gazaki/Retro-Le-Go-Boy/README.md

# Retro-Le-Go-Boy
A ESP32 S3 Retro-go PCB design for the LEGO Gameboy Model
