gazaki/Retro-Le-Go-Boy/V2/KiCad/bom/Retro-Le-Go-Boy v2 DigiKey.xlsx

Country of Origin may be different at time of shipment.
The HTSUS and ECCN information shown is for informational purposes only and is not a representation or warranty as to the accuracy or reliability of these classifications. All information is provided "as is" and is subject to change without notice. Any use made of the information provided is without recourse to Digi-Key and at the user's risk.
Index | Manufacturer Part Number | Manufacturer Name | Description | Lead Time | Availability | Stock Status | Attrition % | Requested Quantity 1 | Pack Quantity 1 | Pack Type 1 | Digi-Key Part Number 1 | Unit Price 1 | Extended Price 1 | Minimum Order Quantity 1 | Customer Reference | Requested Part Number | Lead Weeks | Datasheet | Reference Designator | US Import Tariff | Note | Part Status | RoHS Status | Moisture Sensitivity Level (MSL) | ECCN | HTSUS | Country of Origin | Environmental Information | Original Part numbers | Image | Product Notes
1 | CL10B105KP8NNNC | Samsung Electro-Mechanics | CAP CER 1UF 10V X7R 0603 |  | 3,430,644 | In Stock |  | 6 | 6 | Cut Tape (CT) | 1276-1946-1-ND | 0.08000 | $0.48 | 1 |  | 1276-1946-2-ND | 31 | https://mm.digikey.com/Volume0/opasdata/d220001/medias/docus/3584/CL10B105KP8NNNC_Spec.pdf |  | May apply on shipments to the U.S. |  | Active | ROHS3 Compliant | 1 (Unlimited) | EAR99 | 8532.24.0020 | China | https://www.samsungsem.com/files/fileDown.do?key=ed1dfdfa-645e-4252-b707-17f9b1502dd1|https://www.samsungsem.com/global/support/certificate/product-stewardship.do | 1276-1946-2-ND | https://mm.digikey.com/Volume0/opasdata/d220001/medias/images/2537/Ceramic-Capacitor-CL-Series.jpg
2 | C0603C333J4REC7411 | KEMET | CAP CER 0603 33NF 16V X7R 5% |  | 30,495 | In Stock |  | 6 | 6 | Cut Tape (CT) | 399-C0603C333J4REC7411CT-ND | 0.13000 | $0.78 | 1 |  | 399-C0603C333J4REC7411CT-ND | 13 | https://www.yageogroup.com/content/datasheet/asset/file/KEM_C1090_X7R_ESD |  | N/A |  | Active | ROHS3 Compliant | 1 (Unlimited) | EAR99 | 8532.24.0020 | Mexico |  | 399-C0603C333J4REC7411CT-ND | https://mm.digikey.com/Volume0/opasdata/d220001/medias/images/5352/0603-%281608-Metric%29-Ceramic-Capacitor.jpg
3 | RMCF0603FT10K0 | Stackpole Electronics Inc | RES 10K OHM 1% 1/10W 0603 |  | 3,411,810 | In Stock |  | 7 | 7 | Cut Tape (CT) | RMCF0603FT10K0CT-ND | 0.10000 | $0.70 | 1 |  | RMCF0603FT10K0CT-ND | 18 | https://www.seielect.com/catalog/SEI-RMCF_RMCP.pdf |  | N/A |  | Active | ROHS3 Compliant | 1 (Unlimited) | EAR99 | 8533.21.0030 | Taiwan | https://www.seielect.com/catalog/SEI-RoHS_Compliance_Status.pdf|https://www.seielect.com/catalog/reach.pdf|https://www.seielect.com/catalog/sei-coc%20prop%2065.pdf | RMCF0603FT10K0CT-ND | https://mm.digikey.com/Volume0/opasdata/d220001/medias/images/4322/cut-tape-render.jpg
4 | RMCF0603FT150R | Stackpole Electronics Inc | RES 150 OHM 1% 1/10W 0603 |  | 385,043 | In Stock |  | 6 | 6 | Cut Tape (CT) | RMCF0603FT150RCT-ND | 0.10000 | $0.60 | 1 |  | RMCF0603FT150RCT-ND | 18 | https://www.seielect.com/catalog/SEI-RMCF_RMCP.pdf |  | N/A |  | Active | ROHS3 Compliant | 1 (Unlimited) | EAR99 | 8533.21.0030 | Taiwan | https://www.seielect.com/catalog/SEI-RoHS_Compliance_Status.pdf|https://www.seielect.com/catalog/reach.pdf|https://www.seielect.com/catalog/sei-coc%20prop%2065.pdf | RMCF0603FT150RCT-ND | https://mm.digikey.com/Volume0/opasdata/d220001/medias/images/4849/738_0603.jpg
5 | ESD5Z5.0T1G | onsemi | TVS DIODE 5VWM 18.6VC SOD523 |  | 123,631 | In Stock |  | 2 | 2 | Cut Tape (CT) | ESD5Z5.0T1GOSCT-ND | 0.15000 | $0.30 | 1 |  | ESD5Z5.0T1GOSCT-ND | 41 | https://www.onsemi.com/pdf/datasheet/esd5z2.5t1-d.pdf |  | May apply on shipments to the U.S. |  | Active | ROHS3 Compliant | 1 (Unlimited) | EAR99 | 8541.10.0080 | China | https://www.onsemi.com/site/pdf/RoHS-statement.pdf|https://www.onsemi.com/site/pdf/REACH-compliance-statement.pdf|https://www.onsemi.com/PowerSolutions/MaterialComposition.do?export=pdf&opnId=ESD5Z5.0T1G | ESD5Z5.0T1GOSCT-ND | https://mm.digikey.com/Volume0/opasdata/d220001/medias/images/5883/488%7E502-01%7E%7E2-View-2.jpg
6 | AP2112K-3.3TRG1 | Diodes Incorporated | IC REG LINEAR 3.3V 600MA SOT-25 |  | 223 | In Stock |  | 2 | 2 | Cut Tape (CT) | AP2112K-3.3TRG1DICT-ND | 0.22000 | $0.44 | 1 |  | AP2112K-3.3TRG1DICT-ND | 24 | https://www.diodes.com/assets/Datasheets/AP2112.pdf |  | N/A |  | Active | ROHS3 Compliant | 1 (Unlimited) | EAR99 | 8542.39.0090 | China | https://mm.digikey.com/Volume0/opasdata/d220001/medias/docus/6731/Diode%20RoHS3%20REACH%20247%20Jan%202025%20Statement.pdf | AP2112K-3.3TRG1DICT-ND | https://mm.digikey.com/Volume0/opasdata/d220001/medias/images/6285/31%7ESOT25%7EDA%2CHR%2CHT%2CW%7E5.jpg
7 | MAX98357AETE+T | Analog Devices Inc./Maxim Integrated | IC AMP CLASS D MONO 3.2W 16TQFN |  | 44,573 | In Stock |  | 1 | 1 | Cut Tape (CT) | MAX98357AETE+TCT-ND | 3.19000 | $3.19 | 1 |  | MAX98357AETE+TCT-ND | 17 | https://datasheets.maximintegrated.com/en/ds/MAX98357A-MAX98357B.pdf |  | N/A |  | Active | ROHS3 Compliant | 1 (Unlimited) | EAR99 | 8542.33.0001 | Taiwan | https://www.maximintegrated.com/content/dam/files/design/emmi/rohs-certificate-of-compliance.pdf|https://www.maximintegrated.com/content/dam/files/design/emmi/reach-memo.pdf | MAX98357AETE+TCT-ND | https://mm.digikey.com/Volume0/opasdata/d220001/medias/images/5727/175%7E21-0136%7ETE%7E16.jpg
8 | CL05B104KP5VPNC | Samsung Electro-Mechanics | CAP CER 100NF 10V X7R 0402 |  | 13,515 | In Stock |  | 7 | 7 | Cut Tape (CT) | 1276-CL05B104KP5VPNCCT-ND | 0.10000 | $0.70 | 1 |  | 1276-CL05B104KP5VPNCCT-ND | 31 | https://mm.digikey.com/Volume0/opasdata/d220001/medias/docus/5458/CL05B104KP5VPNC_Spec.pdf |  | N/A |  | Active | ROHS3 Compliant | 1 (Unlimited) | EAR99 | 8532.24.0020 | South Korea |  | 1276-CL05B104KP5VPNCCT-ND | https://mm.digikey.com/Volume0/opasdata/d220001/derivates/6/003/231/813/CL_series_0402_1005_web%28640x640%29.jpg
9 | D2A-2120 | Omron Electronics Inc-EMC Div | SWITCH SNAP ACTION SPDT 0.1A 30V |  | 475 | In Stock |  | 1 | 1 | Tray | SW834-ND | 1.59000 | $1.59 | 1 |  | SW834-ND | 26 | https://omronfs.omron.com/en_US/ecb/products/pdf/en-d2a.pdf |  | N/A |  | Active | RoHS Compliant | 1 (Unlimited) | EAR99 | 8536.50.7000 | China |  | SW834-ND | https://mm.digikey.com/Volume0/opasdata/d220001/medias/images/2455/D2A-2110%2C%20D2A-1110%2C%20D2A-1120%2C%20D2A-2120.jpg
10 | 08184 | SparkFun Electronics | SWITCH THUMBWHEEL DGTL 10MA 5V |  | 317 | In Stock |  | 1 | 1 | Bulk | 1568-08184-ND | 1.75000 | $1.75 | 1 |  | 1568-08184-ND | 12 | https://cdn.sparkfun.com/datasheets/Components/Switches/LEVER8184.pdf |  | N/A |  | Active | ROHS3 Compliant | 1 (Unlimited) | EAR99 | 8536.50.9065 | China |  | 1568-08184-ND | https://mm.digikey.com/Volume0/opasdata/d220001/medias/images/789/MFG_COM-08184.jpg
11 | ESP32-S3-WROOM-1U-N8R8 | Espressif Systems | RF TXRX MOD BT WIFIU.FL SMD |  | 5,905 | In Stock |  | 1 | 1 | Cut Tape (CT) | 1965-ESP32-S3-WROOM-1U-N8R8CT-ND | 6.13000 | $6.13 | 1 |  | 1965-ESP32-S3-WROOM-1U-N8R8CT-ND | 8 | https://www.espressif.com/sites/default/files/documentation/esp32-s3-wroom-1_wroom-1u_datasheet_en.pdf |  | May apply on shipments to the U.S. |  | Active | Unknown | 3 (168 Hours) | 5A992C | 8517.62.0090 | China |  | 1965-ESP32-S3-WROOM-1U-N8R8CT-ND | https://mm.digikey.com/Volume0/opasdata/d220001/medias/images/4233/MFG_Attachment-3-ESP32-S3-WROOM-1U.jpg
12 | AS02808MR-R | PUI Audio, Inc. | SPEAKER 8OHM 1W TOP PORT 80DB |  | 3,252 | In Stock |  | 1 | 1 | Tray | 668-1231-ND | 3.82000 | $3.82 | 1 |  | 668-1231-ND | 29 | https://puiaudio.com/file/specs-AS02808MR-R.pdf |  | May apply on shipments to the U.S. |  | Active | ROHS3 Compliant | Not Applicable | EAR99 | 8518.29.8000 | China |  | 668-1231-ND | https://mm.digikey.com/Volume0/opasdata/d220001/medias/images/650/MFG_AS02808MR-R.jpg
13 | CJ3139KDW-G | Comchip Technology | MOSFET 2P-CH 20V 0.66A SOT363 |  | 842 | In Stock |  | 1 | 1 | Cut Tape (CT) | 641-1793-1-ND | 0.67000 | $0.67 | 1 |  | 641-1793-1-ND | 12 | https://www.comchiptech.com/admin/files/product/QW-BTR52%20CJ3139KDW-G%20RevB.pdf |  | N/A |  | Active | ROHS3 Compliant | 1 (Unlimited) | EAR99 | 8541.21.0095 | Taiwan | https://www.comchiptech.com/admin/files/tech/213_20201006093628.pdf | 641-1793-1-ND | https://mm.digikey.com/Volume0/opasdata/d220001/medias/images/18/SOT-363.jpg
14 | RK10J12E0A0A | Alps Alpine | THUMBWHEEL POT 10KOHM 0.03W TOP |  | 2,069 | In Stock |  | 1 | 1 | Bulk | 4809-RK10J12E0A0A-ND | 2.49000 | $2.49 | 1 |  | 4809-RK10J12E0A0A-ND | 24 | https://tech.alpsalpine.com/e/products/detail/RK10J12E0A0A/ |  | May apply on shipments to the U.S. |  | Active | ROHS3 Compliant | 1 (Unlimited) | EAR99 | 8533.40.8070 | China |  | 4809-RK10J12E0A0A-ND | https://mm.digikey.com/Volume0/opasdata/d220001/medias/images/5657/MFG_RK10J12E0A0A.jpg
15 | UJ20-C-V-C-2-SMT-TR | Same Sky (Formerly CUI Devices) | USB JACK 2.0, TYPE-C, VERTICAL, | 1 expected in stock on 19-Jan-2026 | 0 | Normally Stocking |  | 1 | 1 | Cut Tape (CT) | 2223-UJ20-C-V-C-2-SMT-TRCT-ND | 0.89000 | $0.89 | 1 |  | 2223-UJ20-C-V-C-2-SMT-TRCT-ND | 10 | https://www.sameskydevices.com/product/resource/uj20-c-v-c-2-smt-tr.pdf |  | May apply on shipments to the U.S. |  | Active | RoHS Compliant | Not Applicable | EAR99 | 8536.69.4040 | China |  | 2223-UJ20-C-V-C-2-SMT-TRCT-ND | https://mm.digikey.com/Volume0/opasdata/d220001/derivates/6/003/219/594/MFG_UJ20-C-V-C-2-SMT-TR_web%28640x640%29.jpg
16 | RMCF0603FT1K00 | Stackpole Electronics Inc | RES 1K OHM 1% 1/10W 0603 |  | 4,843,342 | In Stock |  | 2 | 2 | Cut Tape (CT) | RMCF0603FT1K00CT-ND | 0.10000 | $0.20 | 1 |  | RMCF0603FT1K00CT-ND | 18 | https://www.seielect.com/catalog/SEI-RMCF_RMCP.pdf |  | N/A |  | Active | ROHS3 Compliant | 1 (Unlimited) | EAR99 | 8533.21.0030 | Taiwan | https://www.seielect.com/catalog/SEI-RoHS_Compliance_Status.pdf|https://www.seielect.com/catalog/reach.pdf|https://www.seielect.com/catalog/sei-coc%20prop%2065.pdf | RMCF0603FT1K00CT-ND | https://mm.digikey.com/Volume0/opasdata/d220001/medias/images/4322/cut-tape-render.jpg
17 | LMK107BBJ106MALT | Taiyo Yuden | CAP CER 10UF 10V X5R 0603 |  | 856,311 | In Stock |  | 3 | 3 | Cut Tape (CT) | 587-3258-1-ND | 0.08000 | $0.24 | 1 |  | 587-3258-1-ND | 36 | https://mm.digikey.com/Volume0/opasdata/d220001/medias/docus/1231/LMK107BBJ106MALT_SS.pdf |  | N/A |  | Active | ROHS3 Compliant | 1 (Unlimited) | EAR99 | 8532.24.0020 | Malaysia |  | 587-3258-1-ND | https://mm.digikey.com/Volume0/opasdata/d220001/medias/images/4322/cut-tape-render.jpg
18 | TMK107ABJ225KA-T | Taiyo Yuden | CAP CER 2.2UF 25V X5R 0603 |  | 296,806 | In Stock |  | 2 | 2 | Cut Tape (CT) | 587-2909-1-ND | 0.08000 | $0.16 | 1 |  | 587-2909-1-ND | 13 | https://mm.digikey.com/Volume0/opasdata/d220001/medias/docus/4819/TMK107ABJ225KA-T_SS.pdf |  | May apply on shipments to the U.S. |  | Active | ROHS3 Compliant | 1 (Unlimited) | EAR99 | 8532.24.0020 | China |  | 587-2909-1-ND | https://mm.digikey.com/Volume0/opasdata/d220001/medias/images/331/Taiyo-Yuden-0603-%281608-Metric%29.jpg
19 | RMCF0603FT100K | Stackpole Electronics Inc | RES 100K OHM 1% 1/10W 0603 |  | 4,450,151 | In Stock |  | 2 | 2 | Cut Tape (CT) | RMCF0603FT100KCT-ND | 0.10000 | $0.20 | 1 |  | RMCF0603FT100KCT-ND | 18 | https://www.seielect.com/catalog/SEI-RMCF_RMCP.pdf |  | N/A |  | Active | ROHS3 Compliant | 1 (Unlimited) | EAR99 | 8533.21.0030 | Taiwan | https://www.seielect.com/catalog/SEI-RoHS_Compliance_Status.pdf|https://www.seielect.com/catalog/reach.pdf|https://www.seielect.com/catalog/sei-coc%20prop%2065.pdf | RMCF0603FT100KCT-ND | https://mm.digikey.com/Volume0/opasdata/d220001/medias/images/4322/cut-tape-render.jpg
20 | RC0603FR-075K1L | YAGEO | RES 5.1K OHM 1% 1/10W 0603 |  | 556,249 | In Stock |  | 2 | 2 | Cut Tape (CT) | 311-5.10KHRCT-ND | 0.10000 | $0.20 | 1 |  | 311-5.10KHRCT-ND | 18 | https://www.yageogroup.com/content/datasheet/asset/file/PYU-RC_GROUP_51_ROHS_L |  | N/A |  | Active | ROHS3 Compliant | 1 (Unlimited) | EAR99 | 8533.21.0030 | Taiwan | https://www.yageogroup.com/content/Resource%20Library/Product%20Environmental%20Compliance/RoHS_Compliance_YAGEO.pdf | 311-5.10KHRCT-ND | https://mm.digikey.com/Volume0/opasdata/d220001/medias/images/4322/cut-tape-render.jpg
21 | RC0603FR-074K7L | YAGEO | RES 4.7K OHM 1% 1/10W 0603 |  | 2,062,609 | In Stock |  | 1 | 1 | Cut Tape (CT) | 311-4.70KHRCT-ND | 0.10000 | $0.10 | 1 |  | 311-4.70KHRCT-ND | 18 | https://www.yageogroup.com/content/datasheet/asset/file/PYU-RC_GROUP_51_ROHS_L |  | N/A |  | Active | ROHS3 Compliant | 1 (Unlimited) | EAR99 | 8533.21.0030 | Taiwan | https://www.yageogroup.com/content/Resource%20Library/Product%20Environmental%20Compliance/RoHS_Compliance_YAGEO.pdf | 311-4.70KHRCT-ND | https://mm.digikey.com/Volume0/opasdata/d220001/medias/images/4322/cut-tape-render.jpg
22 | RMCF0603FT10R0 | Stackpole Electronics Inc | RES 10 OHM 1% 1/10W 0603 |  | 1,869,774 | In Stock |  | 1 | 1 | Cut Tape (CT) | RMCF0603FT10R0CT-ND | 0.10000 | $0.10 | 1 |  | RMCF0603FT10R0CT-ND | 18 | https://www.seielect.com/catalog/SEI-RMCF_RMCP.pdf |  | N/A |  | Active | ROHS3 Compliant | 1 (Unlimited) | EAR99 | 8533.21.0030 | Taiwan | https://www.seielect.com/catalog/SEI-RoHS_Compliance_Status.pdf|https://www.seielect.com/catalog/reach.pdf|https://www.seielect.com/catalog/sei-coc%20prop%2065.pdf | RMCF0603FT10R0CT-ND | https://mm.digikey.com/Volume0/opasdata/d220001/medias/images/4322/cut-tape-render.jpg
23 | RMCF0603FT1K00 | Stackpole Electronics Inc | RES 1K OHM 1% 1/10W 0603 |  | 4,843,342 | In Stock |  | 1 | 1 | Cut Tape (CT) | RMCF0603FT1K00CT-ND | 0.10000 | $0.10 | 1 |  | RMCF0603FT1K00CT-ND | 18 | https://www.seielect.com/catalog/SEI-RMCF_RMCP.pdf |  | N/A |  | Active | ROHS3 Compliant | 1 (Unlimited) | EAR99 | 8533.21.0030 | Taiwan | https://www.seielect.com/catalog/SEI-RoHS_Compliance_Status.pdf|https://www.seielect.com/catalog/reach.pdf|https://www.seielect.com/catalog/sei-coc%20prop%2065.pdf | RMCF0603FT1K00CT-ND | https://mm.digikey.com/Volume0/opasdata/d220001/medias/images/4322/cut-tape-render.jpg
24 | B1931NG--20D001114U1930 | Harvatek Corporation | LED GREEN DIFFUSED 0603 SMD |  | 46,953 | In Stock |  | 1 | 1 | Cut Tape (CT) | 3147-B1931NG--20D001114U1930CT-ND | 0.10000 | $0.10 | 1 |  | 3147-B1931NG--20D001114U1930CT-ND | 8 | https://mm.digikey.com/Volume0/opasdata/d220001/medias/docus/3633/B1931NG--20D001114U1930.pdf |  | N/A |  | Active | RoHS Compliant | 2A (4 Weeks) | EAR99 | 8541.41.0000 | Taiwan | https://mm.digikey.com/Volume0/opasdata/d220001/medias/docus/6223/Harvatek%20Corp%20REACH%20235%20Jun%202023%20Statement.pdf | 3147-B1931NG--20D001114U1930CT-ND | https://mm.digikey.com/Volume0/opasdata/d220001/medias/images/4437/MFG_B1931.jpg
25 | BAT760 | Shenzhen Slkormicro Semicon Co., Ltd. | 30V INDEPENDENT TYPE 1A 550MV@1A |  | 2,798 | In Stock |  | 1 | 1 | Cut Tape (CT) | 5399-BAT760CT-ND | 0.16000 | $0.16 | 1 |  | 5399-BAT760CT-ND | 4 | https://mm.digikey.com/Volume0/opasdata/d220001/medias/docus/6778/5399_BAT760%20SOD-323.PDF |  | N/A |  | Active | ROHS3 Compliant | 1 (Unlimited) | EAR99 | 8541.10.0080 | China |  | 5399-BAT760CT-ND | https://mm.digikey.com/Volume0/opasdata/d220001/derivates/6/003/227/160/MFG_BAT760_web%28640x640%29.jpg
26 | TP4054 | EVVO | SOT-23-5L BATTERY MANAGEMENT ICS |  | 1,646 | In Stock |  | 1 | 1 | Cut Tape (CT) | 5272-TP4054CT-ND | 0.21000 | $0.21 | 1 |  | 5272-TP4054CT-ND | 3 | https://mm.digikey.com/Volume0/opasdata/d220001/medias/docus/7158/5272_TP4054.pdf |  | N/A |  | Active | ROHS3 Compliant | 1 (Unlimited) | EAR99 | 8542.39.0060 | China |  | 5272-TP4054CT-ND | https://mm.digikey.com/Volume0/opasdata/d220001/derivates/6/003/227/545/MFG_5272_TP4054_third_web%28640x640%29.jpg
27 | S9013 | Shenzhen Slkormicro Semicon Co., Ltd. | TRANS NPN 25V 0.5A SOT-23 |  | 1,522 | In Stock |  | 1 | 1 | Cut Tape (CT) | 5399-S9013CT-ND | 0.10000 | $0.10 | 1 |  | 5399-S9013CT-ND | 4 | https://mm.digikey.com/Volume0/opasdata/d220001/medias/docus/6778/5399_S9013%20SOT-23.PDF |  | N/A |  | Active | Unknown | Not Applicable | EAR99 | 8541.21.0095 | China |  | 5399-S9013CT-ND | https://mm.digikey.com/Volume0/opasdata/d220001/derivates/6/003/232/010/1801%7ESOT23-3%7E%7E3-View-2_web%28640x640%29.jpg
28 | MEM2085-00-115-00-A | GCT | CONN MICRO SD CARD R/A SMD |  | 2,470 | In Stock |  | 1 | 1 | Cut Tape (CT) | 2073-MEM2085-00-115-00-ACT-ND | 0.82000 | $0.82 | 1 |  | 2073-MEM2085-00-115-00-ACT-ND | 10 | https://gct.co/files/specs/mem2085-spec.pdf |  | May apply on shipments to the U.S. |  | Active | ROHS3 Compliant | 1 (Unlimited) | EAR99 | 8536.69.4040 | China | https://gct.co/files/info/gct_certificate_of_compliance.pdf | 2073-MEM2085-00-115-00-ACT-ND | https://mm.digikey.com/Volume0/opasdata/d220001/medias/images/5047/MFG_MEM2085-00-115-00-A.jpg
29 | PAM8302AASCR | Diodes Incorporated | IC AMP CLASS D MONO 2.5W 8MSOP |  | 57,817 | In Stock |  | 1 | 1 | Cut Tape (CT) | PAM8302AASCRDICT-ND | 0.50000 | $0.50 | 1 |  | PAM8302AASCRDICT-ND | 12 | https://www.diodes.com/assets/Datasheets/PAM8302A.pdf |  | May apply on shipments to the U.S. |  | Active | ROHS3 Compliant | 3 (168 Hours) | EAR99 | 8542.33.0001 | China | https://mm.digikey.com/Volume0/opasdata/d220001/medias/docus/6731/Diode%20RoHS3%20REACH%20247%20Jan%202025%20Statement.pdf | PAM8302AASCRDICT-ND | https://mm.digikey.com/Volume0/opasdata/d220001/medias/images/4885/31%7E8MSOP-3%7EM8%2CMM%2CS%2CX%7E8.JPG
