gazaki/Retro-Le-Go-Boy/V2/3D Files/STL/Print Holder.stl

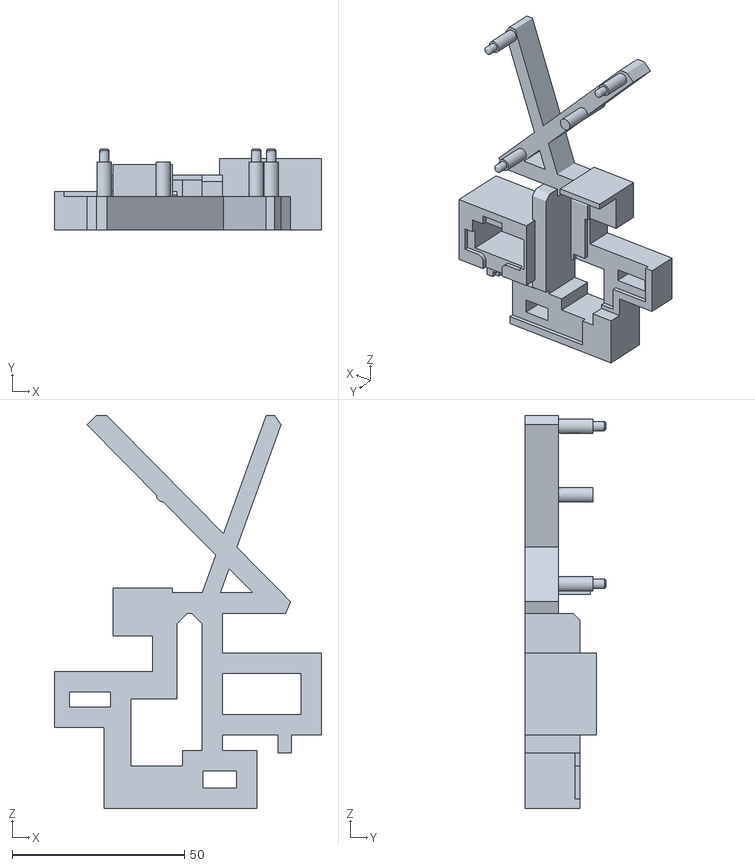
[picture p1: CAD file, 2026-01-06]
V2/3D Files/STL/Print Holder.stl
77.6 x 23.7 x 114.2
