gazaki/Retro-Le-Go-Boy/V2/3D Files/STL/Slider.stl

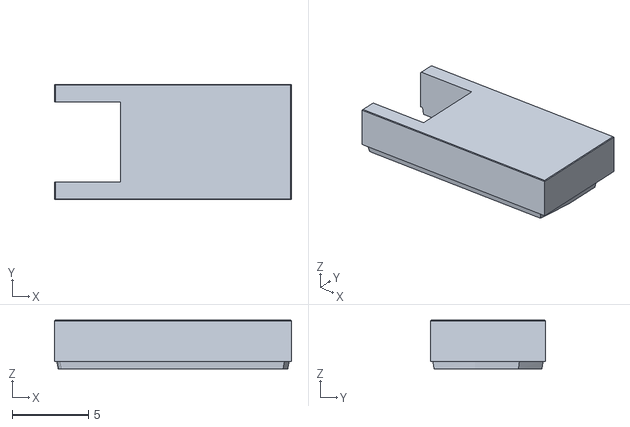
[picture p2: CAD file, 2026-01-05]
V2/3D Files/STL/Slider.stl
15.5 x 7.54 x 3.20
