gazaki/Retro-Le-Go-Boy/V2/3D Files/STL/screen back 1.stl

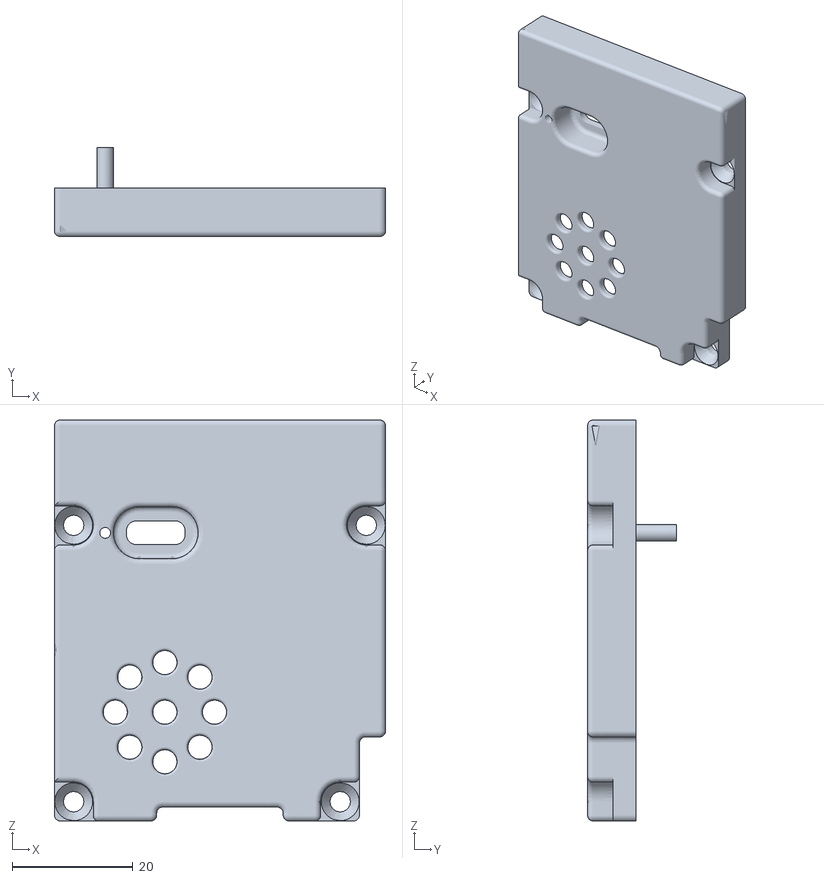
[picture p3: CAD file, 2026-01-05]
V2/3D Files/STL/screen back 1.stl
54.9 x 14.7 x 66.5
