gazaki/Retro-Le-Go-Boy/V2/3D Files/STL/screen back 2.stl

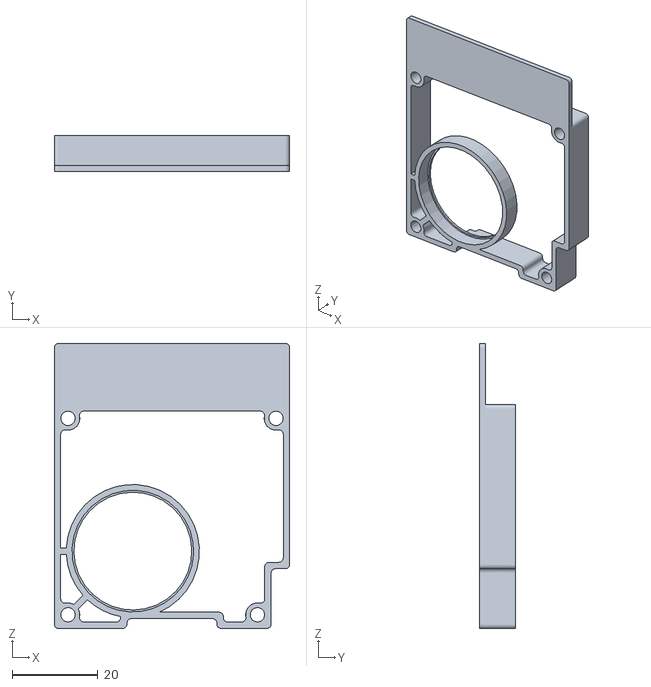
[picture p4: CAD file, 2026-01-05]
V2/3D Files/STL/screen back 2.stl
54.9 x 8.47 x 66.5
