gazaki/Retro-Le-Go-Boy/V2/3D Files/STL/screen front 2.stl

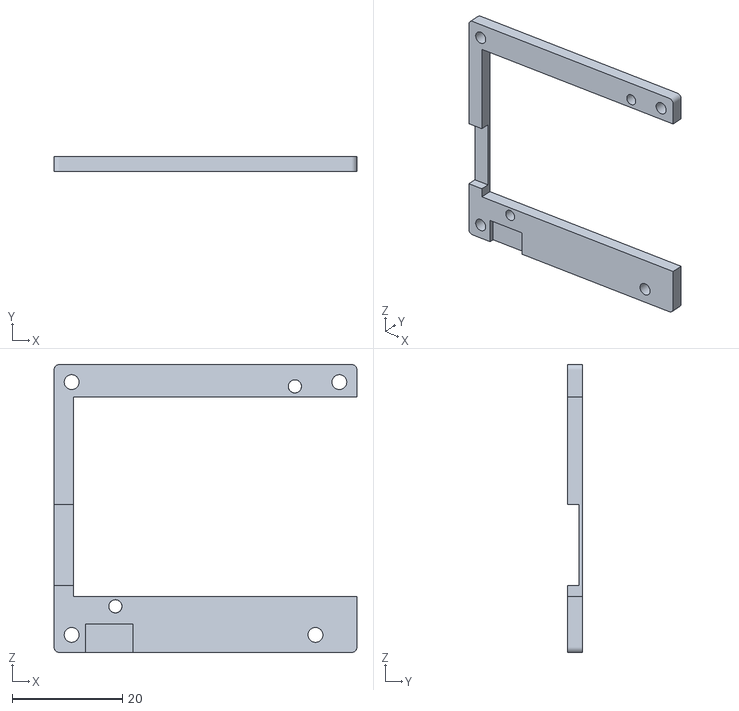
[picture p5: CAD file, 2026-01-05]
V2/3D Files/STL/screen front 2.stl
54.9 x 2.80 x 52.2
