gazaki/Retro-Le-Go-Boy/V2/3D Files/STL/screen front 1.stl

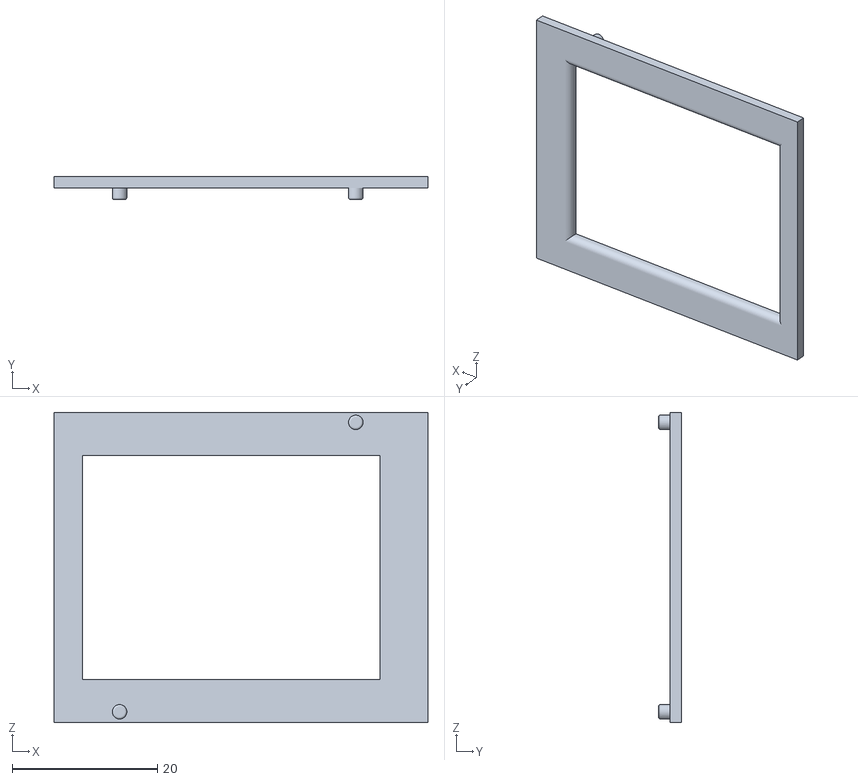
[picture p6: CAD file, 2026-01-05]
V2/3D Files/STL/screen front 1.stl
51.5 x 3.22 x 42.7
