gazaki/Retro-Le-Go-Boy/V2/KiCad/PLOT/Retro-Le-Go-Boy.pdf

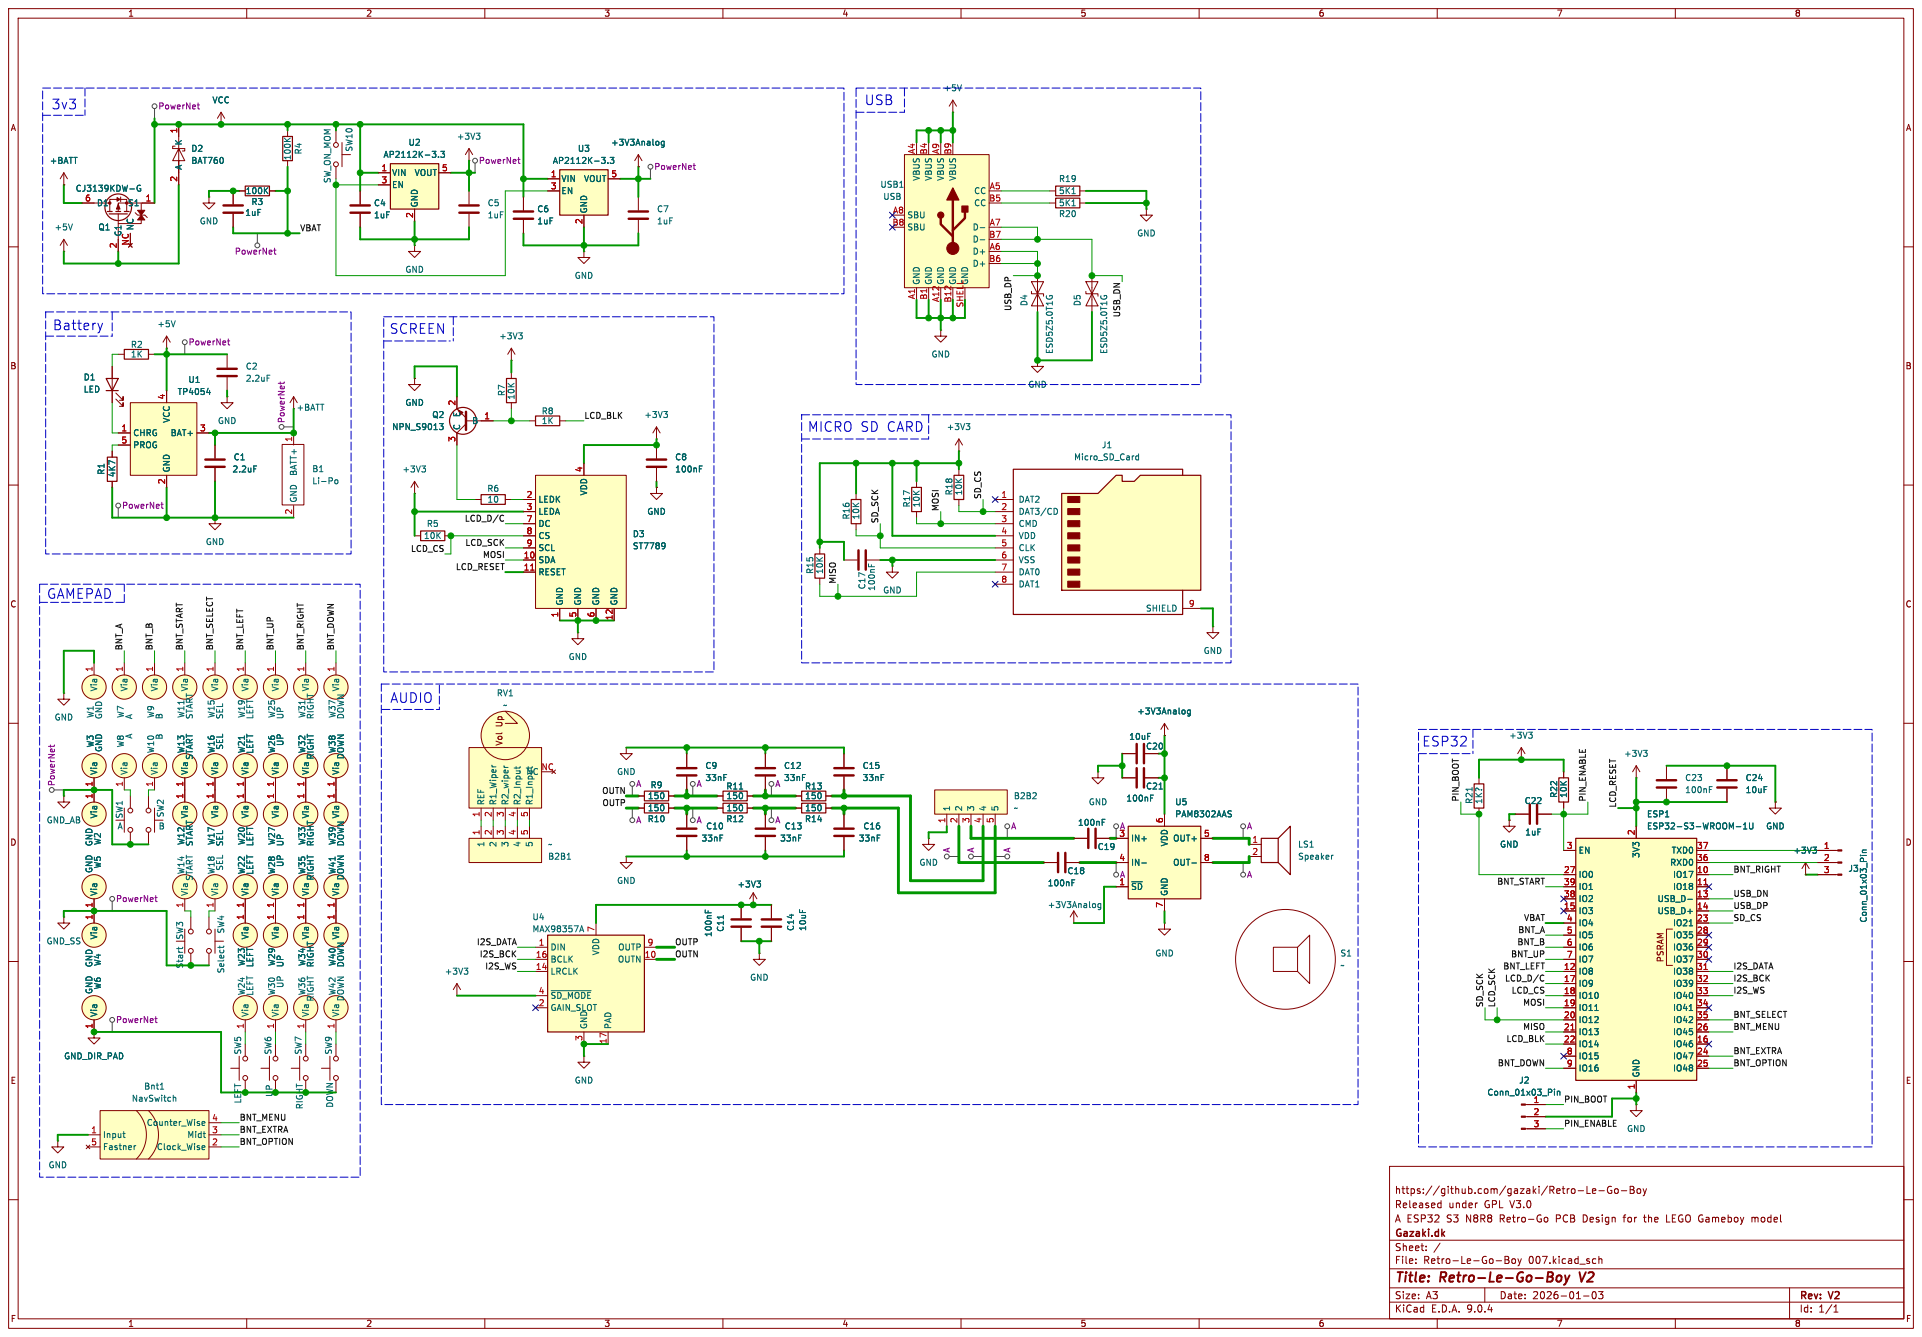
[picture p7: page 1]

2 BAT+ 3 R1 4K7 U2 AP2112K-3.3 VIN 1 EN 3 GND

1 W26UP GND GND Vol Up REF

7 PAD 17 OUTP 9 OUTN 10 U4 MAX98357AGND GND

https://github.com/gazaki/Retro-Le-Go-Boy
