gazaki/Retro-Le-Go-Boy/(commit log)

2026-01-03 Rename Retro-Le-Go-Boy V2.pdf to Schematic/Retro-Le-Go-Boy V2.pdf
    Moved to own folder
2026-01-03 Rename Schematic/Retro-Le-Go-Boy V2.pdf to V2/KiCad/PLOT/Retro-Le-Go-Boy.pdf
